vtmkhoi/DigitalMicroFluidics/docs/jebrail2012.pdf

# Lab on a Chip

## Miniaturisation for chemistry, physics, biology, materials science and bioengineering

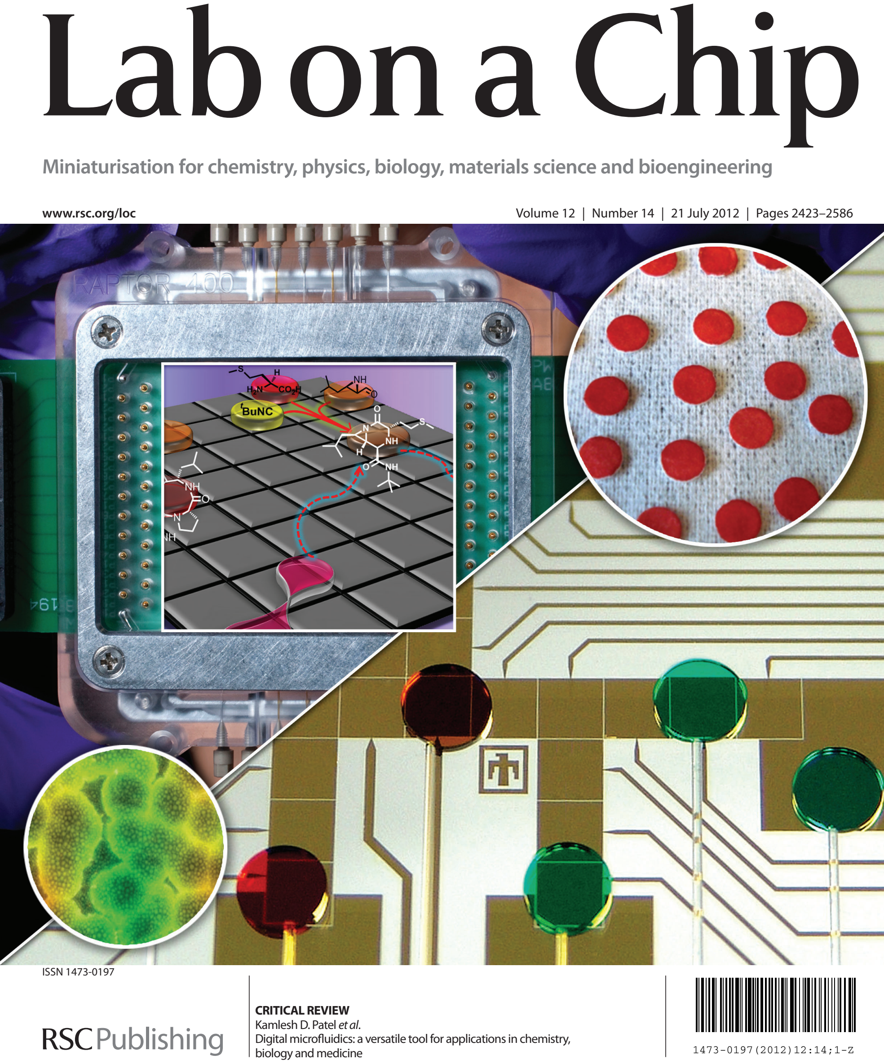
[picture p66: page 1]

1473-0197(2012)12:14;1-Z

ISSN 1473-0197

www.rsc.org/loc | Volume 12 | Number 14 | 21 July 2012 | Pages 2423–2586

CRITICAL REVIEW
Kamlesh D. Patel et al.
Digital microfl uidics: a versatile tool for applications in chemistry, biology and medicine
Downloaded by North Carolina State University on 24 January 2013 Published on 10 May 2012 on http://pubs.rsc.org | doi:10.1039/C2LC40318H View Article Online / Journal Homepage / Table of Contents for this issue

# Digital microfluidics: a versatile tool for applications in chemistry, biology and medicine

Mais J. Jebrail,a Michael S. Bartschb and Kamlesh D. Patel*b

Received 3rd April 2012, Accepted 4th May 2012
DOI: 10.1039/c2lc40318h

Digital microfluidics (DMF) has recently emerged as a popular technology for a wide range of applications. In DMF, nanoliter to microliter droplets containing samples and reagents can be manipulated to carry out a range of discrete fluidic operations simply by applying a series of electrical potentials to an array of patterned electrodes coated with a hydrophobic insulator. DMF is distinct from microchannel-based fluidics as it allows for precise control over multiple reagent phases (liquids and solids) in heterogeneous systems with no need for complex networks of connections, microvalves, or pumps. In this review, we discuss the most recent developments in this technology with particular attention to the potential benefits and outstanding challenges for applications in chemistry, biology, and medicine.

Introduction

The most common format for microfluidics or lab-on-a-chip devices is based on enclosed microchannels in a monolithic substrate. While such systems have been successfully used for applications in chemistry,¹⁻⁵ biology⁶⁻⁹ and medicine,¹⁰⁻¹² in this review, we focus on a related but distinct technology called digital microfluidics (DMF). Like microchannel-based fluidics, DMF is being used to miniaturize a wide range of applications, with the advantages of reduced reagent and solvent consumption, faster reaction rates and the capacity for integration (i.e., the lab-on-a-chip concept). In DMF, discrete droplets of samples and reagents are manipulated (i.e., dispensed from reservoirs, split, merged and mixed) with high-fidelity¹³,14 on an open surface by applying a series of electrical potentials to an array of electrodes.¹⁵,16 Although microchannels can also be used to manipulate droplets,¹⁷,18 typically entrained in an immiscible fluid stream, DMF is a distinct paradigm that offers several unique assets to the lab-on-a-chip field.
One unique feature of DMF is the capacity to address each reagent individually with no need for complex networks of tubing or microvalves (Fig. 1a). A second advantage is the ability to control liquids relative to solids with no risk of clogging – thus, as shown in Fig. 1b, DMF is a good match for the accommodation and analysis of solid samples.¹⁹⁻²² A third asset of DMF is its compatibility with a large range of volumes (see Fig. 1c), making it useful for preparative-scale sample handling.

a
Department of Biotechnology and Bioengineering, Sandia National Laboratories, 7011 East Avenue, MS 9292, Livermore, CA 94550
b
Advance System Engineering and Deployment, Sandia National Laboratories, 7011 East Avenue, MS 9292, Livermore, CA 94550 E-mail: kdpatel@sandia.gov; Fax: +1 925 294 3020; Tel: +1 925 294 3737

Mais J. Jebrail is an NSERC
Postdoctoral | Fellow | in | the
Department of Biotechnology & Bioengineering at Sandia National Laboratories in Livermore, California. Dr Jebrail received his BSc and MSc in Chemistry from York University and his PhD in Interdisciplinary Chemistry from University of Toronto. His primary research focuses on developing microfluidics-based systems for identifying pathogens triggered by bioweapons and infectious diseases.

Michael S. Bartsch is a Senior Member of the Technical Staff at Sandia National Laboratories in Livermore, California. He received a B.M.E. degree from the University of Dayton and MS and PhD degrees in mechanical engineering from Stanford University. His current research focuses on scalable microfluidic systems for micro- and nanoparticle synthesis, digital microfluidics for small scale laboratory automation, and novel bioassay implementations for rapid DNA forensic analysis and biosur-

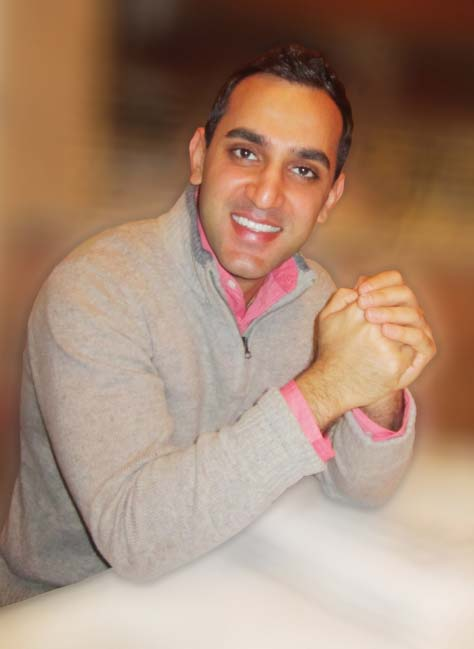
[picture p67: figure]
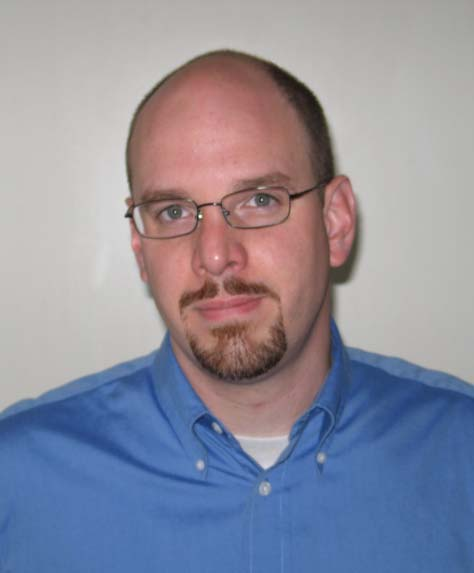
[picture p68: figure]

veillance applications. Mais J. Jebrail

Michael S. Bartsch

Lab on a Chip (http://dx.doi.org/10.1039/c2lc40318h) | Dynamic Article Links (http://dx.doi.org/10.1039/c2lc40318h)

### Cite this: Lab Chip, 2012, 12, 2452–2463

www.rsc.org/loc | CRITICAL REVIEW
2452 | Lab Chip, 2012, 12, 2452–2463 | This journal is -
The Royal Society of Chemistry 2012
Downloaded by North Carolina State University on 24 January 2013 Published on 10 May 2012 on http://pubs.rsc.org | doi:10.1039/C2LC40318H View Article Online

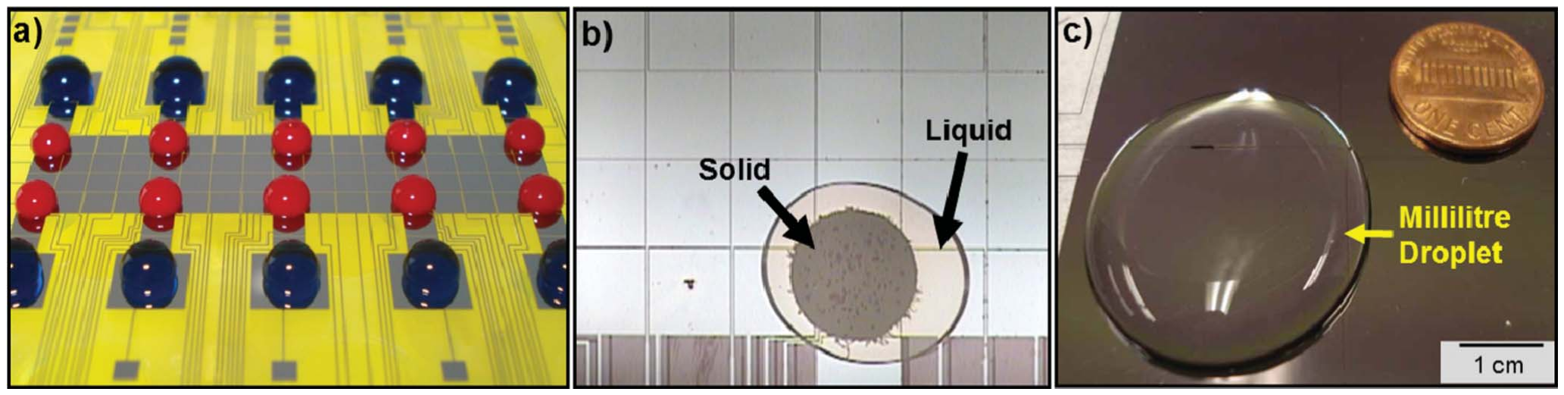
[picture p69: figure]

In this review, we will explore the key capabilities and challenges for DMF, some of which are summarized in Table 1.
The last digital microfluidic review was published in Lab on a Chip in 2009 by Malic et al.²³ Since that time, DMF has matured significantly with publications not reflected in the last review and a number of novel applications now being reported. In the following sections, we describe the physics and formats of digital microfluidics, followed by a discussion of the state-of-the-art for a variety of applications in chemistry, biology, medicine, and beyond.

Physics and formats of digital microfluidics

Digital microfluidics was popularized in the early 2000s by the Fair²⁴ and Kim²⁵ groups at Duke and UCLA, respectively. In these pioneering works, water droplets were made to move across an array of insulated electrodes upon application of electrical potentials. The technique was explained as being driven by surface tension, and was called ‘‘electrowetting’’ or ‘‘electrowetting-on-dielectric’’ (EWOD). This naming convention arose from the observation that the contact angle between an aqueous droplet and the device surface is dramatically reduced (i.e., wetted) during droplet movement. In the electrowetting paradigm, the two phenomena (droplet wetting and movement) were viewed as being cause-and-effect: droplet movement was understood as being a consequence of a force imbalance arising from non-symmetrical contact angles. However, this understanding does not explain droplet motion for liquids with a low surface tension that are movable yet exhibit no apparent changes in contact angle;²⁸ nor can it explain related phenomena such as contact angle saturation (i.e., the observed limit on contact angle change above a threshold in applied potential).
A more complete understanding of the physics of droplet actuation can be derived from electromechanical analysis,²⁹⁻³² which explains both wetting and droplet movement phenomena in terms of the electrical forces generated on free charges in the droplet meniscus (for conductive liquids) or on dipoles inside the droplet (for dielectric liquids). For the purposes of modeling, these forces can be estimated by integrating the Maxwell–Stress tensor, Tij (eqn (1)) (which can be derived from the Lorenz equation³³), over any arbitrary surface around the droplet:³⁰,34

Tij ~ e EiEj{1
2

dijE²

| (1)

where e is the dielectric constant of the medium surrounding the droplet, i and j refer to pairs of x, y, and z axes, dij is the Kronecker delta and E is the applied electric field. Unlike electrowetting, the electromechanical formulation explains the motion of dielectric liquids and liquids that do not experience a change in contact angle. In addition, it provides a rationale for the phenomenon of contact-angle saturation as an equilibrium between electrical and surface-tension forces.³⁰,31
As shown in Fig. 2a, digital microfluidic technology is typically implemented in one of two different configurations: the two-plate or closed format in which droplets are sandwiched between an actuation electrode substrate and a ground plane substrate, and the one-plate or open format in which droplets are placed on top of a single substrate patterned with both actuation and ground electrodes. In both configurations, an insulating layer is deposited on top of the actuation electrodes, and is typically covered by an additional hydrophobic coating to prevent the droplet sticking to the surface.
The two-plate and one-plate digital microfluidic configurations have complementary advantages. Two-plate DMF devices are compatible with the full range of fluidic operations: droplet

Fig. 1 Unique features of digital microfluidics a) DMF platform controlling twenty reagent droplets with no need for external hardware (i.e., connectors, valves, and pumps). Reproduced with permission from ref. 26. Copyright E 2011 Futurity.org. b) Picture of extraction liquid processing a solid dried blood spot by DMF. Reproduced with permission from ref. 21. Copyright E 2011 The Royal Society of Chemistry. c) Picture of a DMF platform used to manipulate a y 3 mL sample droplet. Reproduced with permission from ref. 27. Copyright E 2008 The Royal Society of Chemistry.

Kamlesh D. Patel is a research scientist and manager for the
Advance | Systems | Engineering
and | Development | Group | at
Sandia National Laboratories in Livermore, California. Dr Patel received his BS in Chemistry from Truman State University and PhD in Analytical Chemistry from UNC-Chapel Hill. With a background in separation science and years of experience in microsystems engineering, Dr Patel has applied microfluidic-based technology to new frontiers. Most recently, Dr Patel has turned his

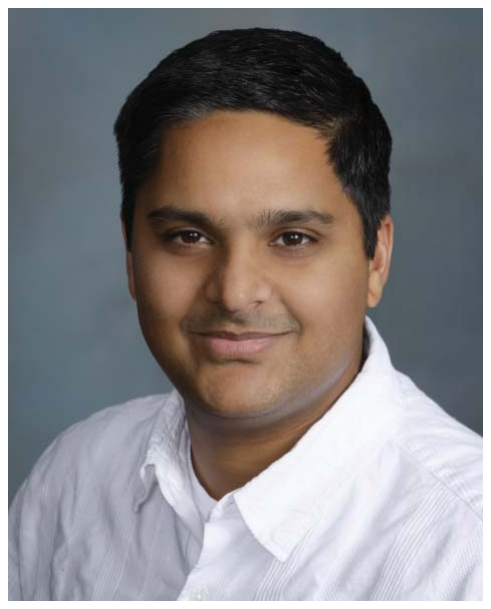
[picture p70: figure]

focus towards automating sample preparation techniques for nextgeneration sequencing, where he hopes to help in developing a strategy to characterize unknown pathogens related to disease outbreak.

Kamlesh D. Patel

This journal is -

The Royal Society of Chemistry 2012 | Lab Chip, 2012, 12, 2452–2463 | 2453
Downloaded by North Carolina State University on 24 January 2013 Published on 10 May 2012 on http://pubs.rsc.org | doi:10.1039/C2LC40318H View Article Online

Table 1 Capabilities of and challenges for digital microfluidics

Capabilities | Challenges
Easy to manipulate reagent droplets with no need for pumps, tubing and microvalves | Not suitable for chemical separations or continuous-flow synthesis
Can handle wide range of volumes (nL–mL), suitable for preparative applications | Incompatible with high temperatures and pressures
Compatible with aqueous and organic solvents | Difficulty moving concentrated biological samples without additives or oil matrix
Straightforward control over different phases | Incompatible with centrifugation
| Dielectric breakdown with high voltage usage

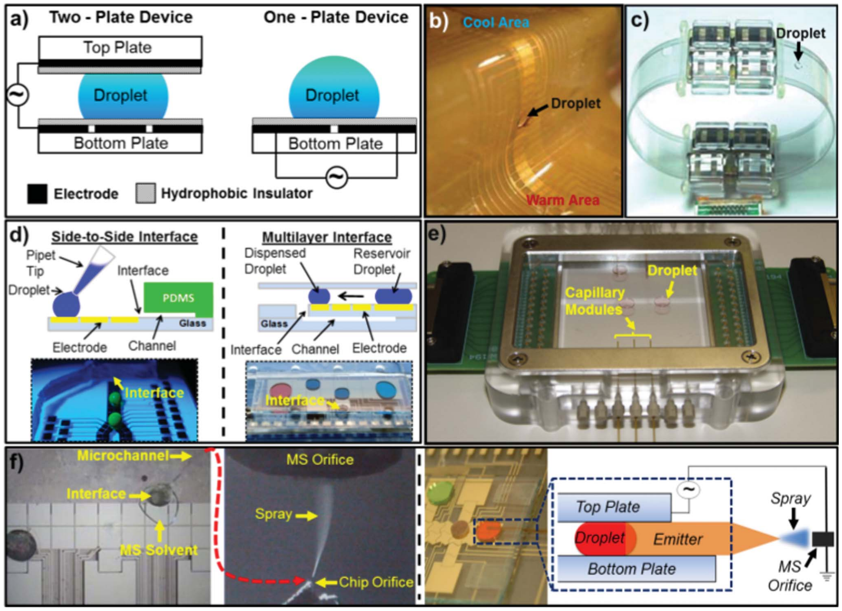
[picture p71: figure]

Fig. 2 Digital microfluidic formats. a) Side-view schematics of two- (left) and one-plate (right) DMF formats. Reproduced with permission from ref.
43. Copyright E 2010 Elsevier B.V. b) Picture of a flexible ‘‘All-Terrain Droplet Actuation’’ device moving a droplet from a warm to a cool area. Reproduced with permission from ref. 27. Copyright E 2008 The Royal Society of Chemistry. c) Picture of a wearable ‘‘droplet-on-a-wristband’’ device. Reproduced with permission from ref. 40. Copyright E 2011 The Royal Society of Chemistry. d) Schematics (top) and pictures (bottom) of two formats of ‘‘hybrid microfluidics,’’ which integrates DMF for sample processing with microchannels for separations. The side-to-side configuration (left) comprises a one-plate DMF device mated to a PDMS microchannel on a common substrate and the multilayer design (right) comprises a DMF array patterned on a top substrate mated to a network of microchannels in a glass substrate below. Reproduced with permission from ref. 42. Copyright E 2010 The American Chemical Society, and ref. 41. Copyright E 2008 The Royal Society of Chemistry. e) Image of a DMF device routing droplets toand-away-from capillary modules that are fixed between lower and upper substrates of DMF device. The electrodes on this device are not visible because they are formed from transparent Indium-Tin Oxide (ITO). Reproduced with permission from ref. 44. Copyright E 2011 Society for Laboratory Automation and Screening. f) Pictures (left) of mass spectrometry (MS) solvent introduced into spray microchannel (via interface hole) and sprayed offtip, and top and side views (right) of a capillary emitter sandwitched between the top and bottom plates of an assembled DMF device. Reproduced with permission from ref. 21. Copyright E 2011 The Royal Society of Chemistry, and ref. 45. Copyright E 2012 The American Chemical Society.
Downloaded by North Carolina State University on 24 January 2013 Published on 10 May 2012 on http://pubs.rsc.org | doi:10.1039/C2LC40318H View Article Online

dispensing, moving, splitting, and merging are all feasible.³⁵ In contrast, one-plate DMF devices are typically not capable of splitting or dispensing functionalities, but facilitate rapid sample and reagent mixing,³⁶ offer the capacity to manipulate large droplets²⁷ and provide better access to samples for external detectors or pipette-based liquid handling.²³
A second key distinction in format for digital microfluidic systems is the nature of the matrix surrounding droplets on the device. For many applications, this matrix is simply ambient air. This format is the most straightforward, but is susceptible to evaporation and may require humidified chambers to overcome this issue.³⁷ Another common format uses a matrix of oil,³⁸ which limits evaporation and reduces the surface energy, and thus requires lower electrical potentials for droplet actuation. Oil-immersed systems have drawbacks, however, including the requirement of gaskets or other structures to contain the oil, the potential for the unwanted liquid–liquid extraction of analytes into the surrounding oil,²⁷ incompatibility with oil-miscible liquids (e.g., organic solvents), and incompatibility with applications requiring drying droplets onto the device surface.³⁹
A third distinction for digital microfluidic device format is device geometry. DMF is typically implemented in planar formats (Fig. 1a), but the use of flexible platforms is growing in popularity. For example, Abdelgawad et al.²⁷ described the format of ‘‘All Terrain Droplet Actuation’’ (ATDA) using devices fabricated on flexible substrates, which were capable of droplet actuation on inclined, declined, and inverted surfaces. This format allows for straightforward integration of multiple physicochemical environments on the same device for applications requiring temperature cycling (Fig. 2b). Similarly, Fan et al.⁴⁰ developed a wearable ‘‘droplet-on-a-wristband’’ device formed from flexible substrates that can fit around patients’ wrists for the potential application of point-of-care testing (Fig. 2c).
A very recent trend for digital microfluidic device format is integration with microchannel-based elements such as separation columns. For example, ‘‘hybrid microfluidics’’⁴¹,42 combines the strength of DMF for sample processing with the speed and sensitivity of microchannel-based separations. Two formats for hybrid microfluidics have been reported. A side-by-side configuration⁴¹ comprises a one-plate DMF device mated to a PDMS microchannel (Fig. 2d, left). Devices formed in this manner were demonstrated to be useful for applications such as in-line sample labelling with fluorogenic reagents followed by separations. A multilayer configuration⁴² comprises a two-plate DMF device on top layers mated to a network of channels on a bottom layer (Fig. 2d, right). This format facilitates the implementation of complex processing regimens (e.g., multi-enzyme digestion of a proteomic sample) followed by electrophoretic separations. A strategy similar to hybrid microfluidics was reported by Gorbatsova et al.,

46 who mated samples controlled by DMF to the inlet of an external capillary for separations. In other work, our group⁴⁴,47 recently developed a novel in-plane capillarydigital microfluidic interface for robustly interconverting liquid samples between continuous-flow and discretized droplet formats (Fig. 2e). The architecture uses the DMF primarily as a central hub for scheduling, routing, and coordinating the transport of multiple reagents between external sample processing modules – in this particular case to prepare nucleic acid samples for next generation sequencing. This strategy has the unique benefit of enabling seamless sample manipulation at the microliter scale while maintaining the flexibility of modular integration.
Methods have also been developed to couple digital microfluidics to nanoelectrospray ionization emitters for direct analysis by mass spectrometry. Jebrail and Yang et al.²¹ initially reported a method relying on multilayer hybrid microfluidics⁴² for in-line analysis, in which samples were transferred from a DMF module (on the top of the device) to a microchannel (on the bottom of the device) with an integrated nanoelectrospray ionization (nESI) emitter for mass spectrometry (Fig. 2f, left). One drawback of this method is the complexity of device fabrication and alignment and the need to thermally bond the two substrates together to form the device. Recently, Shih and Yang et al. reported a new DMF–nESI interface that requires significantly simpler fabrication.⁴⁵ The interface is assembled by inserting a conventional pulled-glass capillary nESI emitter between the top and bottom substrates of an assembled digital microfluidic device (Fig. 2f, right). This interface is similar to work reported simultaneously by Baker and Roper,⁴⁸ but with the key difference being that the nESI interface requires external hardware (i.e., pressure source and N2 gas) for sampling into the mass spectrometer. These approaches show significant potential for future lab-on-a-chip systems.

Digital microfluidic applications in chemistry

The format of digital microfluidics, in which droplets can be used as individually addressable microreactors, seems well suited for chemical synthesis. This idea was reinforced when Chatterjee et al.²⁸ demonstrated the capacity of DMF to actuate organic solvents including acetone, acetonitrile, ethanol, dichloromethane and others. In an early demonstration of chemical applications in DMF format, Millman et al.⁴⁹ synthesized a wide variety of micro-particles, including capsules, semiconducting microbeads, and inhomogeneous striped and ‘‘eyeball’’ particles (Fig. 3a). Droplets containing suspensions of micro/nano particles, polymer solutions, and polymer precursors were merged and mixed to yield the different types of particles. In another example of synthesis applications on digital microfluidc devices, Dubois et al.⁵⁰ implemented Grieco’s reaction using ionic liquid droplets as microreactors to synthesize tetrahydroquinolines. In this reaction, an onium salt is reacted with benzaldehyde derivatives and excess indene in an ionic liquid matrix to obtain tetrahydroquinolines. Ionic liquids are advantageous for this application because of their low vapor pressure – reactions can be implemented in small droplets (, 1 mL) on single-plate devices with no evaporation. In addition, ionic liquids have other advantages for use with DMF, such as intrinsic conductivity and thermal stability.
While the studies described above established the compatibility of digital microfluidics with chemical synthesis, they used simple one-plate devices that were capable of carrying out only a single, serial reaction with no dispensing, splitting, active mixing, or flexibility in droplet volumes. The Wheeler group introduced the first two-plate DMF platform for chemical synthesis that is suitable for the control of multi-step reactions in parallel.⁵¹ This platform was used to carry out the synchronized synthesis of five peptide macrocycles from three different components (amino
The Royal Society of Chemistry 2012 | Lab Chip, 2012, 12, 2452–2463 | 2455
Downloaded by North Carolina State University on 24 January 2013 Published on 10 May 2012 on http://pubs.rsc.org | doi:10.1039/C2LC40318H View Article Online

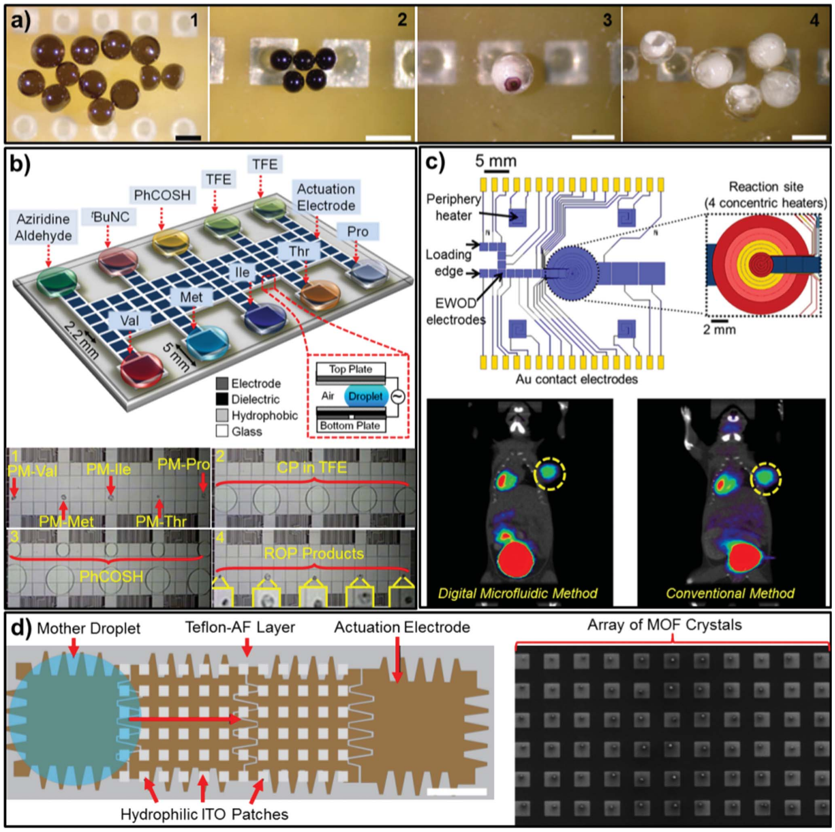
[picture p72: figure]

Fig. 3 Digital microfluidic applications in chemistry. a) Pictures depicting micro-particles synthesized using DMF. The products include conductive gold/SU-8 particles (1), semiconducting polypyrrole particles (2), ‘‘eyeball’’ microbeads (3), and cup-shaped particles formed by drying water droplets that were originally encapsulated in latex (4). Scale bars are 1 mm; reprinted with permission from ref. 49. Copyright E 2005 Nature Publishing Group.
b) Schematic (top) of a DMF device used for synchronized synthesis, and sequence of frames from a movie (bottom) illustrating the steps in DMF synthesis of aziridine ring-opened peptide (ROP) products. Peptide macrocycles (PM) are solubilized in trifluoroethanol (TFE) (frames 1,2), then merged (frames 3,4) with droplets containing thiobenzoic acid (PhCOSH), followed by isolation of the ROP products. The insets in frame 4 are magnified images of the dried products. Reproduced with permission from ref. 51. Copyright E 2010 John Wiley & Sons, Inc. c) Schematic (top) of a DMF device with four concentric heaters for synthesis of radiotracer [¹⁸F]FDG, and positron emission tomography images of a mouse bearing a lymphoma xenograft tumor in the right shoulder (dashed circle) after administration of [¹⁸F]FDG prepared by DMF (left) and conventional method (right). Reproduced with permission from ref. 52. Copyright E 2012 National Academy of Sciences. d) Top-view schematic (left) of a mother droplet moving across an array of indium-tin oxide (ITO) micropatches formed in a Teflon-AF background matrix and a scanning electron microscope image of single metal–organic framework (MOF) crystal arrays (right) synthesized by DMF. Reproduced with permission from ref. 53. Copyright E 2012 John Wiley & Sons, Inc.
Downloaded by North Carolina State University on 24 January 2013 Published on 10 May 2012 on http://pubs.rsc.org | doi:10.1039/C2LC40318H View Article Online

acids, aziridine aldehyde and tert-butyl isocyanide) followed by late-stage modification with thiobenzoic acid to generate aziridine ring-opened products. As shown in Fig. 3b, the DMF device featured ten reagent reservoirs and eighty-eight actuation electrodes dedicated to dispensing, merging, and mixing droplets of reagents and products. In other work, Keng et al.⁵² developed an integrated two-plate DMF device with four concentric heaters for synthesizing 2-[¹⁸F]fluoro-2-deoxy-D-glucose ([¹⁸F]FDG), a widely used radiotracer for imaging living subjects with positron emission tomography, with high and reliable radio-fluorination efficiency (. 85%) (Fig. 3c, top). DMF synthesized [¹⁸F]FDG was biodistributed (in vivo) in mice bearing lymphoma xenograft tumors and exhibited comparable uptake in tumors to [¹⁸F]FDG prepared using conventional methods (Fig. 3c, bottom). Finally, Witters et al. used DMF to synthesize single metal–organic framework (MOF) crystals in a high-throughput fashion.⁵³ As shown in Fig. 3d, library HKUST-1 [Cu3(BTC)2] crystals were printed by transporting a mother droplet of HKUST-1 precursor solution over an array of indium-tin oxide micropatches (in a Teflon-AF background matrix) on the top plate of a DMF device. Among other benefits, the authors anticipate that this technology can pave the way for straightforward post-synthesis modification of printed MOF crystals with different functionalities.
In comparison with other microfluidic technologies (e.g., enclosed microchannels), digital microfluidics is particularly well suited to synthesis, as DMF allows for precise control over multiple reagent phases. For example, a critical step in the synthesis of aziridine ring-opened products (as described above) is the removal of the solvent and re-dissolution of the crystalline peptide macrocycles for further processing (Fig. 3b, frames 1–2). This highlights the flexibility of DMF – the solvent volumes used to re-dissolve a particular solid can be readily varied. This stands in contrast to microchannel-based systems, in which working volumes are defined by the channel dimensions and cannot be changed.
The most useful features of digital microfluidics for synthesis include the individual addressing of all reagents with no need for complex networks of microvalves,⁵⁴,55 chemically inert Teflonbased device surfaces that facilitate the use of organic solvents and easy access to reasonably large amounts of products for off-chip analysis. On the other hand, DMF is not appropriate for all synthetic applications; for example, reactions performed at high temperatures and pressures or those that require in-line purification are better suited for closed microchannel systems⁵⁶ and there are several unique advantages associated with modular continuous flow reactors formed in microchannels (also known as mesofluidics¹,57). Nevertheless, the potential benefits of DMF as a synthetic platform have yet to be fully explored, suggesting considerable room for innovation in the future.

Digital microfluidic applications in biology

Digital microfluidics is an attractive platform for biological applications,⁴³ which often require the use of expensive or precious reagents. A challenge for such applications is the nonspecific adsorption of biological molecules to device surfaces (biofouling), which can lead to sample loss or cross-contamination. In the context of DMF, biomolecules adsorbed to device surfaces can result in droplet sticking, which can render fouled devices useless. Strategies have been developed to overcome this problem. For example, DMF devices making use of an oil matrix reduce the opportunity for biomolecules to come into contact with surfaces, which limits the extent of fouling.⁵⁸ For applications that are not compatible with oil, an alternative strategy is to mix samples and reagents with low concentrations of additives such as PluronicE⁵⁹,60 or graphene oxide⁶¹, which facilitates the actuation of serum and other concentrated biochemical reagents while reducing fouling. Lastly, one can use a removable hydrophobic insulator, such that each successive experiment is implemented on a fresh device surface.⁶² These adaptations have made DMF compatible with a wide range of applications in biology, as described below.
Handling and characterizing samples of DNA have become critical steps for a wide range of applications, especially molecular biology. Accordingly, a number of examples of digital microfluidic DNA manipulation have been published. Early studies included using DMF to study the repair of oxidized lesions in oligonucleotides by Jary et al.⁶³ In this work, droplets containing a DNA repair enzyme and damaged DNA were merged by DMF, incubated, and then the repaired DNA was detected by fluorescence microscopy. Liu et al.⁶⁴ demonstrated a similar application, in which a DMF device was developed to facilitate DNA ligation by merging droplets containing vector DNA and the enzyme, DNA ligase. In other studies, Malic et al.⁶⁵,66 carried out the on-chip immobilization of thiolated DNA probes followed by hybridization with droplets containing complementary oligonucelotide target sequences. Measurements were carried out by surface plasmon resonance imaging and revealed a two-fold increase in the efficiency of DNA immobilization under an applied potential in comparison to passive immobilization.
The most complete DNA application using DMF was initially reported by Chang et al.,

67 who implemented the polymerase chain reaction (PCR). In this work, a DMF device with an embedded micro-heater was developed to facilitate thermal cycling. The fluorescent signals from DNA amplified on-chip were comparable to those generated using a bench-scale PCR machine with 50% and 70% reductions in total time and sample consumption, respectively. In other work, Sista et al.⁶⁸ performed a 40-cycle real-time PCR in 12 min by shuttling a droplet through different temperature zones. In addition, Pollack and coworkers from Advanced Liquid Logic (ALL; www.liquidlogic.com) improved on previous methods by developing a multifunctional DMF cartridge capable of performing real-time PCR, immunoassays and sample preparation assays.⁶⁹ The cartridge was operated using a custom-built benchtop instrument equipped with all of the required control and detection capabilities for performing multiplexed real-time PCR. More recently, the same group utilized their digital microfluidic-based instrument to sequence DNA using a pyrosequencing method (Fig. 4a).⁷⁰ For proof-of-concept, a portion of a 229 bp Candida parapsilosis template was sequenced and over 60 bp of sequence was generated with 100% accuracy. Lastly, our group developed a DMF distribution hub for integrating multiple subsystem modules for automated library template construction for next generation sequencing (NGS). This DMF hub platform not only executed the sample preparation protocol,⁴⁴ but also integrated a

The Royal Society of Chemistry 2012 | Lab Chip, 2012, 12, 2452–2463 | 2457
Downloaded by North Carolina State University on 24 January 2013 Published on 10 May 2012 on http://pubs.rsc.org | doi:10.1039/C2LC40318H View Article Online

quantitative capillary electrophoresis module for the size-based quality control of the library prior to sequencing.⁴⁷
Digital microfluidics has also been applied to conduct enzyme assays. In one of the first reports, Taniguchi et al.⁷¹ demonstrated a bioluminescence assay for ATP using the luciferase enzyme. Later, Nichols and Gardeniers⁷² carried out timesensitive measurements by using DMF to mix the reagents and MALDI time-of-flight mass spectrometry to investigate the presteady-state kinetics of the enzyme, tyrosine phosphatase. Subsequently, Miller⁷³ et al. applied DMF to the study of enzyme kinetics by mixing and merging droplets of alkaline phosphatase with fluorescein diphosphate on a multiplexed DMF device. Enzyme reaction coefficients, Km and kcat, generated by DMF agreed with literature values, and the assays used much smaller volumes and had higher sensitivity than conventional methods. Recently, Fiddes and Luk et al.²² also demonstrated the action of alkaline phosphatase on fluorescein diphosphate using cylindrical hydrogel discs incorporated in DMF devices (Fig. 4b). In this work, agarose gel discs were modified with alkaline phosphatase enzyme molecules, and droplets containing fluorescein diphosphate were dispensed and merged onto the gels for the cleavage of phosphate groups and the generation of fluorescein.
The capacity to address many reagents and phases simultaneously makes digital microfluidics a good fit for applications in proteomics as well. Early work in this area focused on the combination of DMF sample handling with detection by matrix assisted laser desorption ionization mass spectrometry (MALDI-MS).³⁹,74,75 More recently, Jebrail et al. implemented a DMF-based protocol for extracting and purifying proteins from complex biological mixtures (e.g., serum and cell lysate) by precipitation, rinsing, and resolubilization.¹⁹ The method has protein recovery efficiencies comparable to conventional techniques (¢ 80%) and has the benefit of not requiring centrifugation. Processes relying on centrifugation are challenging to implement in most systems based on lab-on-a-chip devices, including DMF, and are therefore avoided whenever possible. In other work, Luk et al.⁷⁶ and Chatterjee et al.⁷⁷ applied DMF to key proteomic processing steps that commonly follow protein extraction, including reduction, alkylation, and digestion. Nelson et al.⁷⁸ improved upon these techniques by integrating resistive heating and temperature sensing elements for straightforward integration with MALDI-MS (Fig. 4c). Jebrail et al.⁷⁹ integrated many of these methods into an automated digital platform including protein precipitation, rinsing, resolubilization, reduction, alkylation, and digestion. Finally, Luk and Fiddes et al.⁸⁰ integrated agarose discs (y2 mm diameter) bearing immobilized enzymes (e.g., trypsin or pepsin) into DMF systems for digesting proteins. Digital microfluidics has also proven to be a useful platform for carrying out immunoassays. Sista et al.⁸¹ reported a dropletbased magnetic bead immunoassay using DMF to detect insulin and interleukin-6. In this work, a droplet of analyte and a second droplet containing magnetic beads (modified with capture antibodies), blocking proteins, and reporter antibodies were merged to form capture antibody–antigen–reporter antibody complexes. A magnet was then used to immobilize the beads such that the supernatant could be driven away. The assay had low detection limits: less than 10 pmol L²¹ and 5 pg mL²¹ for insulin and interleukin-6, respectively. In a separate study, Sista

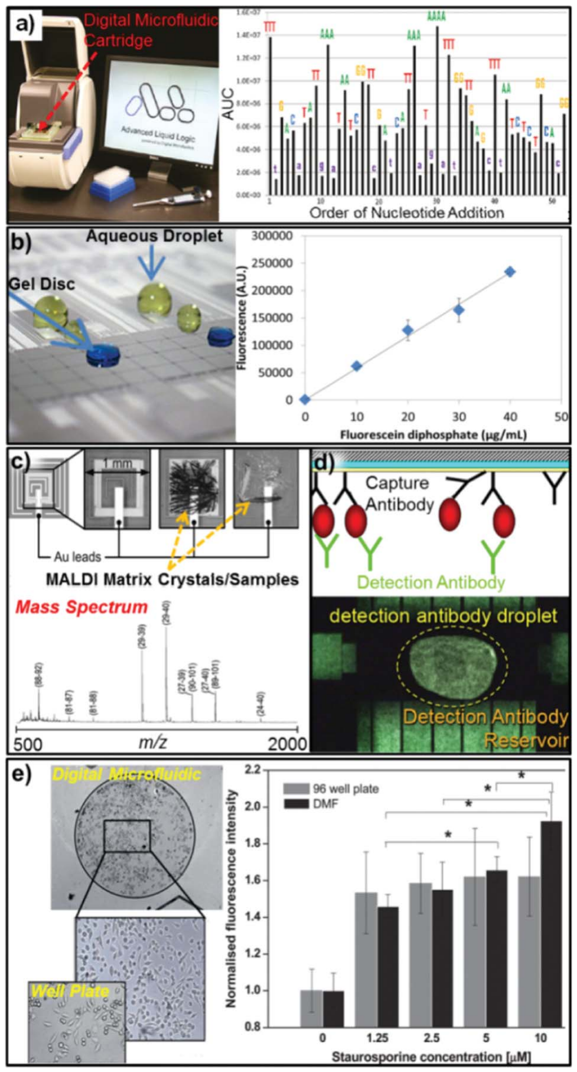
[picture p73: figure]

Fig. 4 Digital microfluidic applications in biology. a) Picture (left) of a sequencing instrument from Advanced Liquid Logic, and a pyrogram (right) of the Candida parapsilosis template. Reproduced with permission from ref. 70. Copyright E 2011 The American Chemical Society. b) Image (left) of gel discs on a DMF device with no top plate and the fluorescence response curve (right) as a function of fluorescein diphosphate concentration. Reproduced with permission from ref. 22. Copyright E 2012 American Institute of Physics. c) Pictures (top) of a MALDI matrix and sample crystals grown after the evaporation of the solvent by resistive heating and a MALDI-MS spectrum (bottom) of cytochrome c digested at 40 uC. Reproduced with permission from ref. 78. Copyright E 2010 The American Chemical Society. d) Schematic (top) depicting an IgG sandwich immunoassay, and picture (bottom) of a droplet containing detection antibody (FITC-labeled anti-IgG). Reproduced with permission from ref. 82. Copyright E 2011 Springer. e) Pictures (left) of HeLa cells on a hydrophilic site on a DMF device and (inset) cells grown on a well-plate, and the dose-response curve (right) of caspase-3 activity as a function of staurosporine concentration from cells assayed on a 96 well plate and DMF device. Reproduced with permission from ref. 83. Copyright E 2012 The Royal Society of Chemistry.

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

et al. implemented a similar method for detecting cardiac troponin I in whole blood.⁶⁸ Recently, Miller et al.⁸² developed a DMF platform for similar immunoassay applications implemented without beads or magnets. As shown in Fig. 3d, the method relied on device surfaces modified with spots of capture antibody (Fc-specific anti-human IgG), which binds antigen to the droplet sample and is in turn recognized by detection antibodies.
Cell-based assays have also been a popular target for digital microfluidics, as the reagents and other materials are often prohibitively expensive for large-volume techniques. In their initial work, Barbulovic-Nad et al. implemented a toxicity assay in which droplets carrying Jurkat-T cells were merged with droplets containing different concentrations of the surfactant Tween 20 (lethal to cells) and were then merged again with droplets carrying viability dyes to generate dose-response curves.⁸⁴ The DMF assay was more sensitive than conventional methods and had no significant effects on cell vitality. This agrees with a study conducted by Zhou et al., in which no increase in the number of dead osteoblasts was observed after droplet actuation.⁸⁵ Fan et al.⁸⁶ used dielectrophoresis to separate neuroblastoma cells to different regions of droplets that were manipulated by DMF. The original droplets were then split into daughter droplets containing different cell densities. Shah et al.⁸⁷ improved upon these techniques by integrating DMF with optoelectronic tweezers for precise cell handling. The Wheeler group developed a DMF-driven method of solution replacement for complete cell culture (i.e., cell seeding, growth, detachment, and re-seeding on a fresh surface, etc.) and analysis, which they have termed ‘‘passive dispensing.’’ 37,88,89 In this approach, an aqueous droplet is driven across a hydrophilic site formed on the surface of the bottom³⁷ or top plate⁸⁸,89 of a DMF device, which results in the spontaneous formation of a sub-droplet dubbed a ‘‘virtual microwell’’. Utilizing the above mechanism, Bogojevic et al.⁸³ recently developed the first DMF device implementing a multiplexed cell-based apoptosis assay. In this work, HeLa cells were seeded and grown on hydrophilic sites patterned on the top plate of DMF device, and a 6-plex caspase-3 activity assay was conducted using staurosporine as a model agonist (Fig. 4e). The method generated dose-response profiles of caspase-3 activity as a function of staurosporine concentration comparable to conventional techniques (i.e., pipetting, aspiration, and 96-well plates.), but it yielded lower detection limits, greater dynamic range, and a 33-fold reduction in reagent consumption. Note that the above cell based assays required low PluronicE concentrations (0.02–0.2% w/v) to facilitate cell droplet movement.

Digital microfluidic applications in medicine

The precise control over different reagents, phases (i.e., liquids relative to solids¹⁹,20,51,80,90 and immiscible solvents²⁰,91) and volumes afforded by digital microfluidics makes it well suited to applications in medicine. In an important first step toward clinical applications, the Fair group³⁸ developed a series of glucose assays in physiological fluids (serum, saliva, plasma, and urine) with actuation by DMF (see Fig. 4a). More recently, Sista et al.⁶⁸ developed a DMF technique to extract DNA from whole blood samples using magnetic beads with integrated analyses by immunoassays and PCR.
Noha and Jebrail et al. developed a digital microfluidic method for processing 1 mg samples of breast tissue homogenate and 1 mL samples of blood and serum for the quantitation of steroid hormones.²⁰ In a typical assay, a sample was chemically lysed, the estradiol extracted into a polar solvent, the unwanted constituents were extracted into a nonpolar solvent by liquid– liquid extraction and the extract was delivered to a collection reservoir for off-chip analysis (Fig. 4b). The DMF method uses a sample size that is 1000–4000 times smaller than conventional methods for the extraction and quantification of steroids and was 20–30 times faster.
Digital microfluidic techniques provide similar benefits for analyzing newborn dried blood spot (DBS, i.e., a sample of filter paper bearing dried blood) samples used to screen for metabolic disorders. Recently, a cover story in Chemical & Engineering News⁹³ described the increasing prevalence of DBS samples for disease detection and drug development, driven by advantages such as small sample consumption, easy shipment and storage and reduced use of animal testing. However, DBS samples present several challenges, including manual processing (e.g., solvent extraction) and lengthy analysis times⁹³, drawbacks that can potentially be alleviated when using DMF.
The Wheeler group²¹ reported the first microfluidic method for in-line extraction and analysis of analytes in DBS samples by mass spectrometry. In this work, biomarkers for amino acid metabolism disorders (e.g., methionine, phenylalanine and tyrosine) were extracted from the DBS of newborn patients and derivatized using digital microfluidics, then quantified by tandem mass spectrometry (Fig. 5c). The prototype microfluidic system was able to correctly identify newborn patients suffering from metabolic disorders (e.g., phenylketonuria) while significantly reducing the required sample volume (20 mL vs. 170– 450 mL) and analysis time (y1h vs. . 3.5 h) relative to conventional methods. In a separate study, the same group improved on their previous method by including a new, straightforward interface between DMF and mass spectrometry for in-line analysis.⁴⁵ This method was used to perform on-chip extraction and quantification of succinylacetone, a specific marker of tyrosinemia type 1, in DBS samples. Finally, Advanced Liquid Logic validated a disposable DMF cartridge for rapid, multiplexed analysis of newborn DBS extracts for lysosomal storage diseases (Fig. 5d).⁹² Eleven DBS extracts were simultaneously processed on a single cartridge and analyzed for Pompe and Fabry disorders (caused by acid a-glucosidase and a-galactosidase deficiencies) using fluorometric enzyme assays. These new DMF methods have the potential to contribute to a new generation of analytical techniques for quantifying analytes in DBS samples in a wide range of applications.

Cross-cutting applications

The unique characteristics of digital microfluidics have also made this technology attractive for a diverse set of applications that do not fit neatly into a single category as described above. For example, Zhao et al.⁹⁴ manipulated air bubbles instead of droplets on DMF devices and used these bubbles to effect a chemical reaction between gaseous reagents. In other work,

The Royal Society of Chemistry 2012 | Lab Chip, 2012, 12, 2452–2463 | 2459
Downloaded by North Carolina State University on 24 January 2013 Published on 10 May 2012 on http://pubs.rsc.org | doi:10.1039/C2LC40318H View Article Online

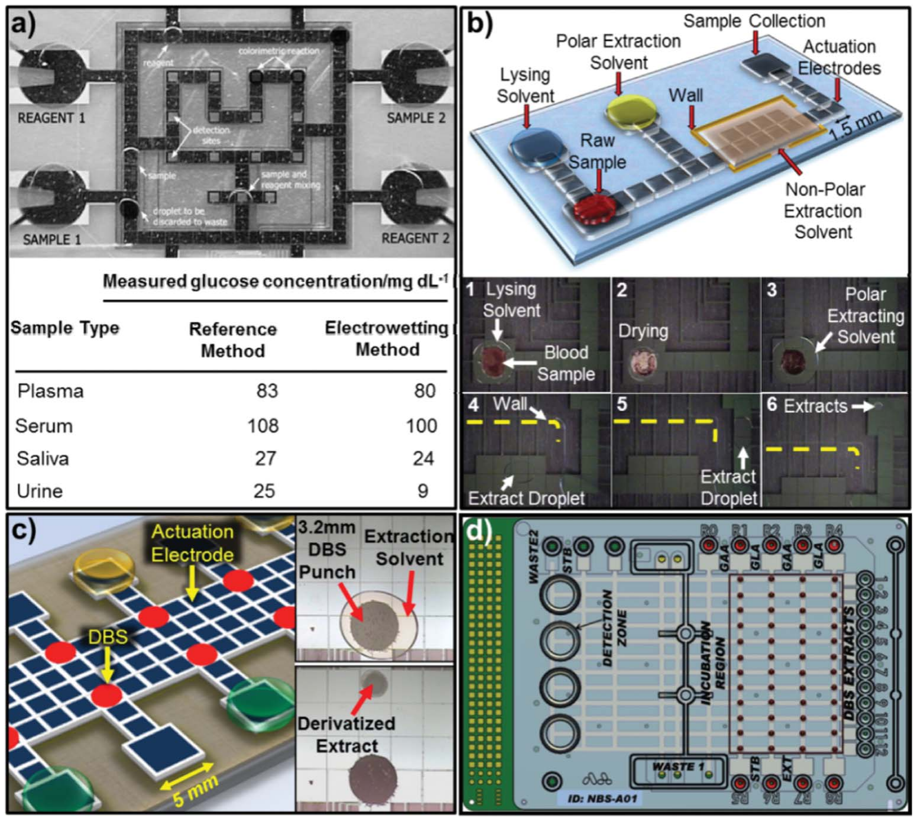
[picture p74: figure]

droplets controlled by DMF were used to collect particles from the surfaces of perforated microfilter membranes, which may be useful for sampling bioaerosols in environmental monitoring applications.⁹⁵ Gao et al. used DMF for rapid colorimetric detection of mercury(II) by mixing a detector droplet composed of a conjugated polymer and a label-free mercury-specific oligonucleotide probe with a mercury ioncontaining droplet.⁹⁶ Recently, Kuehne et al.⁹⁷ reported the miniaturization of dye-lasers by using DMF. As shown in Fig. 6b, the emission wavelength of the DMF dye laser can be altered by moving droplets of different dye solutions in and out of an excitation beam. This technique has the potential to be beneficial for a wide range of applications requiring on-chip optical sensing.
In another example, Polous et al.⁹⁸ developed an integrated DMF device bearing thin-film electrodes for the formation and analysis of lipid bilayer membranes (Fig. 6c). In this work, aqueous droplets surrounded by a lipid-containing organic oil were moved close to each other and lipid bilayer formation at the interface was probed using electrochemical techniques. Son et al.⁹⁹ used DMF to transport and process relatively large living organisms, as shown in Fig. 6d. For example, the dechorionation (i.e., removing the chorion of an embryo to facilitate microinjection and accelerate growth) of a zebrafish embryo was carried out by merging droplets containing digestive reagents and an embryo. This work represents an initial step towards using DMF as an alternative to microwell plates for applications involving multicellular organisms.
Au and Shih et al.¹⁰⁰ reported a microbioreactor powered by DMF for the automated culture and on-chip analysis of microorganisms (e.g., bacteria, algae and yeast). Lapierre et al.¹⁰¹ coupled DMF to a surface-assisted laser desorption– ionization (SALDI) silicon nanowire-based interface for mass spectrometry (MS) analysis. The integrated system allows for a rapid, straightforward and highly sensitive MS analysis of small biomolecules. Finally, Choi et al.¹⁰² equipped a DMF device with field effect transistors (FET) to electrically detect biomolecules. As shown in Fig. 6e, FET-based biosensors were embedded in the center of droplet-actuation electrodes for tracing an influenza antibody in real-time without labeling.

Fig. 5 Digital microfluidic applications in medicine. a) Picture of DMF (top) used to perform glucose assays, and table (bottom) comparing glucose concentrations in different samples obtained by DMF and a reference method. Reproduced with permission from ref. 38. Copyright E 2004 The Royal Society of Chemistry. b) Schematic (top) of a DMF device for extracting and purifying estrogen from tissue, blood, or serum, and a series of frames (bottom) from a movie (1 to 6) illustrating the key steps in the DMF-based extraction of estrogen from a 1 ml droplet of human blood. Reproduced with permission from ref. 20. Copyright E 2009 The American Association for the Advancement of Science. c) Schematic of dried blood spots (DBS) on a DMF device (left) and pictures (right) depicting sample processing of a single 3.2 mm DBS by DMF. Reproduced with permission from ref. 21. Copyright E 2011 The Royal Society of Chemistry. d) Schematic of disposable DMF cartridge developed by Advanced Liquid Logic Inc. for multiplexed enzyme analyses of DBS extracts. Reproduced with permission from ref. 92. Copyright E 2011 The American Association for Clinical Chemistry.

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

Summary and outlook for the future

Since its debut in the early 2000s as a basic method for moving water droplets on a surface, digital microfluidics (DMF) has matured from something of a curiosity into a technology that is making unique contributions to laboratory practice in chemistry, biology, medicine, and other fields. The most active application area for DMF so far has been biology, but we expect this to change in the future as the unique features of DMF become more widely recognized. For example, we believe that the potential benefits of DMF for chemical synthesis and multiphase sample manipulation have yet to be fully investigated and exploited. Moreover, we anticipate that DMF will increasingly find applications in portable and deployable applications like forensic science, biosurveillance, and environmental sampling. Several of the advantages and disadvantages of DMF described here are listed in Table 1. While challenges remain, DMF technology has matured rapidly in a fairly short time and shows great promise for growth beyond academic and research labs. At least one company, Advanced Liquid Logic (ALL), has been established to translate the capabilities of DMF to end users, and there are likely to be others. Moreover, ancillary players such as Luminex Corporation (www.luminexcorp.com) and NuGen Technologies (www.nugeninc.com) are partnering with ALL and others to develop small-footprint, cost-efficient systems that reduce labor costs and produce fast and accurate analytical results. In the next decade, we speculate that an everexpanding community of researchers spanning academia, industry, and government will continue to push DMF technology to address an ever-growing list of challenging problems in chemistry, biology, medicine, and beyond.

Acknowledgements

We sincerely thank Dr Aaron Wheeler and the members of the Wheeler Lab for being a key resource and engaging in helpful discussions during the preparation of this manuscript. MJJ thanks the Natural Sciences and Engineering Research Council (NSERC) of Canada and the Sandia Laboratory Directed Research and Development (LDRD) program for funding. Sandia is a multiprogram laboratory operated by the Sandia Corporation, a Lockheed Martin Company, for the United States Department of Energy’s National Nuclear Security Administration under contract DE-AC04-94Al85000.

References

1 I. R. Baxendale, S. V. Ley, A. C. Mansfield and C. D. Smith, Angew. Chem., Int. Ed., 2009, 48, 4017–4021.
2 S. Marre and K. F. Jensen, Chem. Soc. Rev., 2010, 39, 1183–1202. 3 B. F. Cottam, S. Krishnadasan, A. J. de Mello, J. C. de Mello and
M. S. P. Shaffer, Lab Chip, 2007, 7, 167–169.
4 Y. J. Wang, W. Y. Lin, K. Liu, R. J. Lin, M. Selke, H. C. Kolb,
N. G. Zhang, X. Z. Zhao, M. E. Phelps, C. K. F. Shen, K. F. Faull and H. R. Tseng, Lab Chip, 2009, 9, 2281–2285.
5 Y. Hennequin, N. Pannacci, C. P. De Torres, G. Tetradis-Meris,
S. Chapuliot, E. Bouchaud and P. Tabeling, Langmuir, 2009, 25, 7857–7861.
6 D. Chen, W. Du, Y. Liu, W. Liu, A. Kuznetsov, F. E. Mendez,
L. H. Philipson and R. F. Ismagilov, Proc. Natl. Acad. Sci. U. S. A., 2008, 105, 16843–16848.
7 A. B. Theberge, F. Courtois, Y. Schaerli, M. Fischlechner, C. Abell,
F. Hollfelder and W. T. S. Huck, Angew. Chem.-Int. Edit., 2010, 49, 5846–5868.

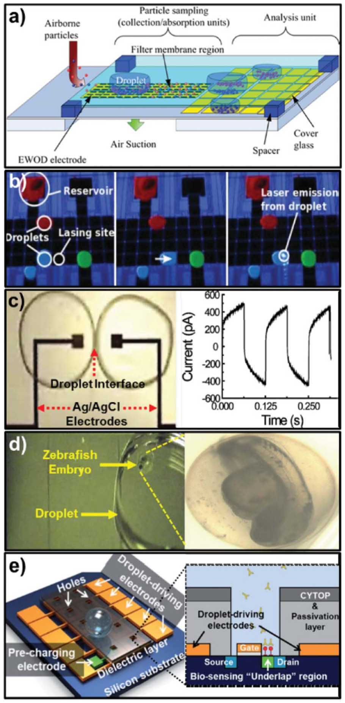
[picture p75: figure]

Fig. 6 Cross-cutting applications of digital microfluidics. a) A schematic of a DMF-powered monitoring system for airborne particle sampling and analysis. Reproduced with permission from ref. 95. Copyright E 2009 IOP Publishing. b) Images from left to right of a blue dye droplet actuated to the lasing site by DMF for emission. Reproduced with permission from ref. 97. Copyright E 2011 The Royal Society of Chemistry. c) Picture (left) of a DMF device integrated with Ag/AgCl electrodes controlling two aqueous droplets, each surrounded by a lipid-containing organic phase, and electrical measurement (right) of bilayer formation at the interface of the two droplets. Reproduced with permission from ref. 98. Copyright E 2009 American Institute of Physics.
d) Picture of a digital microfluidic device controlling a droplet containing a zebrafish embryo for processing (left) and picture (right) of a magnified embryo on the device. Reproduced with permission from ref. 99. Copyright E 2009 The Royal Society of Chemistry. e) Top-view schematic of a DMF device embedded with field effect transistors (FET) biosensors (left) and an exploded cross-sectional view of the biosensor (right). Reproduced with permission from ref. 102. Copyright E 2012 The Royal Society of Chemistry.
The Royal Society of Chemistry 2012 | Lab Chip, 2012, 12, 2452–2463 | 2461
Downloaded by North Carolina State University on 24 January 2013 Published on 10 May 2012 on http://pubs.rsc.org | doi:10.1039/C2LC40318H View Article Online

8 S. Ko¨ster, F. E. Angile`, H. Duan, J. J. Agresti, A. Wintner, C. Schmitz, A. C. Rowat, C. A. Merten, D. Pisignano, A. D. Griffiths and D. A. Weitz, Lab Chip, 2008, 8, 1110–1115.
9 R. W. Doebler, B. Erwin, A. Hickerson, B. Irvine, D. Woyski, A. Nadim and J. D. Sterling, JALA, 2009, 14, 119–125.
10 C. W. Yung, J. Fiering, A. J. Mueller and D. E. Ingber, Lab Chip, 2009, 9, 1171–1177.
11 D. Wlodkowic and J. M. Cooper, Curr. Opin. Chem. Biol., 2010, 14, 556–567.
12 R. Fan, O. Vermesh, A. Srivastava, B. K. H. Yen, L. Qin, H. Ahmad, G. A. Kwong, C. C. Liu, J. Gould, L. Hood and J. R. Heath, Nat. Biotechnol., 2008, 26, 1373–1378.
13 S. C. C. Shih, R. Fobel, P. Kumar and A. R. Wheeler, Lab Chip, 2011, 11, 535–540.
14 J. Gong and C. J. Kim, Lab Chip, 2008, 8, 898–906.
15 M. Abdelgawad and A. R. Wheeler, Adv. Mater., 2009, 21, 920–925. 16 A. R. Wheeler, Science, 2008, 322, 539–540.
17 S. Y. Teh, R. Lin, L. H. Hung and A. P. Lee, Lab Chip, 2008, 8, 198–220.
18 P. Tabeling, Lab Chip, 2009, 9, 2428–2436.
19 M. J. Jebrail and A. R. Wheeler, Anal. Chem., 2009, 81, 330–335. 20 N. A. Mousa, M. J. Jebrail, H. Yang, M. Abdelgawad, P. Metalnikov,
J. Chen, A. R. Wheeler and R. F. Casper, Sci. Transl. Med., 2009, 1, 1ra2.
21 M. J. Jebrail, H. Yang, J. M. Mudrik, N. M. Lafreniere, C. McRoberts, O. Y. Al-Dirbashi, L. Fisher, P. Chakraborty and A. R. Wheeler, Lab Chip, 2011, 11, 3218–3224.
22 L. K. Fiddes, V. N. Luk, S. H. Au, A. H. C. Ng, V. M. Luk, E. Kumacheva and A. R. Wheeler, Biomicrofluidics, 2012, 6, 014112. 23 L. Malic, D. Brassard, T. Veres and M. Tabrizian, Lab Chip, 2010, 10, 418–431.
24 M. G. Pollack, R. B. Fair and A. D. Shenderov, Appl. Phys. Lett., 2000, 77, 1725–1726.
25 J. Lee, H. Moon, J. Fowler, T. Schoellhammer and C. J. Kim, Sens. Actuators, A, 2002, 95, 259–268.
26 L. Mitchell, Digital chip analyzes blood from tiny drop from Futurity August, 2011,http://www.futurity.org/top-stories/digital-chip-analyzesblood-from-tiny-drop/(accessed 27 February 2012).
27 M. Abdelgawad, S. L. S. Freire, H. Yang and A. R. Wheeler, Lab Chip, 2008, 8, 672–677.
28 D. Chatterjee, B. Hetayothin, A. R. Wheeler, D. J. King and R. L. Garrell, Lab Chip, 2006, 6, 199–206.
29 T. B. Jones, Langmuir, 2002, 18, 4437–4443.
30 K. H. Kang, Langmuir, 2002, 18, 10318–10322.
31 E. Baird, P. Young and K. Mohseni, Microfluid. Nanofluid., 2007, 3, 635–644.
32 D. Chatterjee, H. Shepherd and R. L. Garrell, Lab Chip, 2009, 9, 1219–1229.
33 D. J. Griffiths, Introduction to Electrodynamics, 3 edn, Prentice-Hall, New Jersey, 1999.
34 M. Abdelgawad, P. Park and A. R. Wheeler, J. Appl. Phys., 2009, 105, 094506–094512.
35 S. K. Cho, H. J. Moon and C. J. Kim, J. Microelectromech. Syst., 2003, 12, 70–80.
36 C. G. Cooney, C. Y. Chen, M. R. Emerling, A. Nadim and J. D. Sterling, Microfluid. Nanofluid., 2006, 2, 435–446.
37 I. Barbulovic-Nad, S. H. Au and A. R. Wheeler, Lab Chip, 2010, 10, 1536–1542.
38 V. Srinivasan, V. K. Pamula and R. B. Fair, Lab Chip, 2004, 4, 310–315.
39 H. Moon, A. R. Wheeler, R. L. Garrell, J. A. Loo and C. J. Kim, Lab Chip, 2006, 6, 1213–1219.
40 S. K. Fan, H. Yang and W. Hsu, Lab Chip, 2011, 11, 343–347. 41 M. Abdelgawad, M. W. L. Watson and A. R. Wheeler, Lab Chip, 2009, 9, 1046–1051.
42 M. W. L. Watson, M. J. Jebrail and A. R. Wheeler, Anal. Chem., 2010, 82, 6680–6686.
43 M. J. Jebrail and A. R. Wheeler, Curr. Opin. Chem. Biol., 2010, 14, 574–581.
44 H. Kim, M. S. Bartsch, R. F. Renzi, J. He, J. L. Van de Vreugde,
M. R. Claudnic and K. D. Patel, J. Lab. Autom., 2011, 16, 405–414. 45 S. C. C. Shih, H. Yang, M. J. Jebrail, R. Fobel, N. McIntosh, O. Y. Al-Dirbashi, P. Chakraborty and A. R. Wheeler, Anal. Chem., 2012, 84, 3731–3738.

46 J. Gorbatsova, M. Jaanus and M. Kaljurand, Anal. Chem., 2009, 81, 8590–8595.
47 N. Thaitrong, H. Kim, R. F. Renzi, M. S. Bartsch, R. J. Meagher and K. D. Patel, 2012Submitted.
48 C. A. Baker and M. G. Roper, Anal. Chem., 2012, 84, 2955, DOI: 10.1021/ac300100b.
49 J. R. Millman, K. H. Bhatt, B. G. Prevo and O. D. Velev, Nat. Mater., 2004, 4, 98–102.
50 P. Dubois, G. Marchand, Y. Fouillet, J. Berthier, T. Douki, F. Hassine,
S. Gmouh and M. Vaultier, Anal. Chem., 2006, 78, 4909–4917.
51 M. J. Jebrail, A. H. C. Ng, V. Rai, R. Hili, A. K. Yudin and A. R. Wheeler, Angew. Chem., Int. Ed., 2010, 49, 8625–8629.
52 P. Y. Keng, S. Chen, H. Ding, S. Sadeghi, G. J. Shah, A. Dooraghi,
M. E. Phelps, N. Satyamurthy, A. F. Chatziioannou, C. J. Kim and
R. M. Van Dam, Proc. Natl. Acad. Sci. U. S. A., 2011, 109, 690–695. 53 D. Witters, N. Vergauwe, R. Ameloot, S. Vermeir, D. De Vos, R. Puers, B. Sels and J. Lammertyn, Adv. Mater., 2012, 24, 1316–1320. 54 J. Y. Wang, G. D. Sui, V. P. Mocharla, R. J. Lin, M. E. Phelps,
H. C. Kolb and H. R. Tseng, Angew. Chem., Int. Ed., 2006, 45, 5276–5281.
55 Y. Kikutani, T. Horiuchi, K. Uchiyama, H. Hisamoto, M. Tokeshi and T. Kitamori, Lab Chip, 2002, 2, 188–192.
56 E. R. Murphy, J. R. Martinelli, N. Zaborenko, S. L. Buchwald and
K. F. Jensen, Angew. Chem., Int. Ed., 2007, 46, 1734–1737.
57 M. Baumann, I. R. Baxendale, S. V. Ley, N. Nikbin, C. D. Smith and J. P. Tierney, Org. Biomol. Chem., 2008, 6, 1577–1586.
58 V. Srinivasan, V. K. Pamula and R. B. Fair, Anal. Chim. Acta, 2004, 507, 145–150.
59 V. N. Luk, G. C. H. Mo and A. R. Wheeler, Langmuir, 2008, 24, 6382–6389.
60 S. H. Au, P. Kumar and A. R. Wheeler, Langmuir, 2011, 27, 8586–8594.
61 G. Perry, V. Thomy, M. R. Das, Y. Coffinier and R. Boukherroub, Lab Chip, 2012, 12, 1601.
62 H. Yang, V. N. Luk, M. Abeigawad, I. Barbulovic-Nad and A. R. Wheeer, Anal. Chem., 2009, 81, 1061–1067.
63 D. Jary, A. Chollat-Namy, Y. Fouillet, J. Boutet, C. Chabrol, G. Castellan, D. Gasparutto and C. Peponnet, Proceedings of 2006 NSTI Nanotechnology Conference and Trade Show, 2006, 2554–557. 64 Y. J. Liu, D. J. Yao, H. C. Lin, W. Y. Chang and H. Y. Chang,
J. Micromech. Microeng., 2008, 18, 045017.
65 L. Malic, T. Veres and M. Tabrizian, Biosens. Bioelectron., 2009, 24, 2218–2224.
66 L. Malic, T. Veres and M. Tabrizian, Biosens. Bioelectron., 2011, 26, 2053–2059.
67 Y. H. Chang, G. B. Lee, F. C. Huang, Y. Y. Chen and J. L. Lin, Biomed. Microdevices, 2006, 8, 215–225.
68 R. Sista, Z. S. Hua, P. Thwar, A. Sudarsan, V. Srinivasan, A. Eckhardt, M. Pollack and V. Pamula, Lab Chip, 2008, 8, 2091–2104. 69 Z. Hua, J. L. Rouse, A. E. Eckhardt, V. Srinivasan, V. K. Pamula,
W. A. Schell, J. L. Benton, T. G. Mitchell and M. G. Pollack, Anal. Chem., 2010, 82, 2310–2316.
70 D. J. Boles, J. L. Benton, G. J. Siew, M. H. Levy, P. K. Thwar,
M. A. Sandahl, J. L. Rouse, L. C. Perkins, A. P. Sudarsan, R. Jalili,
V. K. Pamula, V. Srinivasan, R. B. Fair, P. B. Griffin, A. E. Eckhardt and M. G. Pollack, Anal. Chem., 2011, 83, 8439–8447. 71 T. Taniguchi, T. Torii and T. Higuchi, Lab Chip, 2002, 2, 19–23. 72 K. P. Nichols and J. G. E. Gardeniers, Anal. Chem., 2007, 79, 8699–8704. 73 E. M. Miller and A. R. Wheeler, Anal. Chem., 2008, 80, 1614–1619. 74 A. R. Wheeler, H. Moon, C. J. Kim, J. A. Loo and R. L. Garrell, Anal. Chem., 2004, 76, 4833–4838.
75 A. R. Wheeler, H. Moon, C. A. Bird, R. R. O. Loo, C. J. Kim, J. A. Loo and R. L. Garrell, Anal. Chem., 2005, 77, 534–540.
76 V. N. Luk and A. R. Wheeler, Anal. Chem., 2009, 81, 4524–4530. 77 D. Chatterjee, A. J. Ytterberg, S. U. Son, J. A. Loo and R. L. Garrell, Anal. Chem., 2010, 82, 2095–2101.
78 W. C. Nelson, I. Peng, G. A. Lee, J. A. Loo, R. L. Garrell and C. J. Kim, Anal. Chem., 2010, 82, 9932–9937.
79 M. J. Jebrail, V. N. Luk, S. C. C. Shih, R. Fobel, A. H. C. Ng, H. Yang, S. L. S. Freire and A. R. Wheeler, J. Vis. Exp., 2009, e1603, DOI: 1610.3791/1603.
80 V. N. Luk, L. K. Fiddes, V. M. Luk, E. Kumacheva and A. R. Wheeler, Proteomics, 2012, 12, 1310, DOI: 10.1002/pmic.201100608. 81 R. S. Sista, A. E. Eckhardt, V. Srinivasan, M. G. Pollack, S. Palanki and V. K. Pamula, Lab Chip, 2008, 8, 2188–2196.
Downloaded by North Carolina State University on 24 January 2013 Published on 10 May 2012 on http://pubs.rsc.org | doi:10.1039/C2LC40318H View Article Online

82 E. M. Miller, A. H. C. Ng, U. Uddayasankar and A. R. Wheeler, Anal. Bioanal. Chem., 2010, 399, 337–345.
83 D. Bogojevic, M. D. Chamberlain, I. Barbulovic-Nad and A. R. Wheeler, Lab Chip, 2012, 12, 627–634.
84 I. Barbulovic-Nad, H. Yang, P. S. Park and A. R. Wheeler, Lab Chip, 2008, 8, 519–526.
85 J. Zhou, L. Lu, K. Byrapogu, D. Wootton, P. Lelkes and R. Fair, Virtual Phys. Prototyping, 2007, 2, 217–223.
86 S. K. Fan, P. W. Huang, T. T. Wang and Y. H. Peng, Lab Chip, 2008, 8, 1325–1331.
87 G. J. Shah, A. T. Ohta, E. P. Y. Chiou, M. C. Wu and C. J. Kim, Lab Chip, 2009, 9, 1732–1739.
88 S. Srigunapalan, I. A. Eydelnant, C. A. Simmons and A. R. Wheeler, Lab Chip, 2012, 12, 369–375.
89 I. A. Eydelnant, U. Uddayasankar, B. Li, M. W. Liaoab and A. R. Wheeler, Lab Chip, 2012, 12, 750–757.
90 H. Yang, J. M. Mudrik, M. J. Jebrail and A. R. Wheeler, Anal. Chem., 2011, 83, 3824–3830.
91 P. A. L. Wijethunga, Y. S. Nanayakkara, P. Kunchala, D. W. Armstrong and H. Moon, Anal. Chem., 2011, 83, 1658–1664.

92 R. S. Sista, A. E. Eckhardt, T. Wang, C. Graham, J. L. Rouse, S. M. Norton, V. Srinivasan, M. G. Pollack, A. A. Tolun, D. Bali, D. S. Millington and V. K. Pamula, Clin. Chem., 2011, 57, 1444–1451. 93 C. Arnaud, Chem. Eng. News, 2011, 89, 13–17.
94 Y. Zhao and S. K. Cho, Lab Chip, 2007, 7, 273–280.
95 Y. Zhao, S. K. Chung, U. C. Yi and S. K. Cho, J. Micromech. Microeng., 2008, 18.
96 A. Gao, X. Liu, T. Li, P. Zhou, Y. Wang, Q. Yang, L. Wang and C. Fan, IEEE Sens. J., 2011, 11, 2820–2824.
97 A. J. C. Kuehne, M. C. Gather, I. A. Eydelnant, S. H. Yun, D. A. Weitz and A. R. Wheeler, Lab Chip, 2011, 11, 3716–3719.
98 J. L. Poulos, W. C. Nelson, T. J. Jeon, C. J. Kim and J. J. Schmidt, Appl. Phys. Lett., 2009, 95.
99 S. U. Son and R. L. Garrell, Lab Chip, 2009, 9, 2398–2401.
100 S. H. Au, S. C. C. Shih and A. R. Wheeler, Biomed. Microdevices, 2010, 13, 41–50.
101 F. Lapierre, G. Piret, H. Drobecq, O. Melnyk, Y. Coffinier, V. Thomy and R. Boukherroub, Lab Chip, 2011, 11, 1620–1628. 102 K. Choi, J.-Y Kim, J.-H. Ahn, J.-M. Choi, M. a. Imb and Y.-K. Choi, Lab Chip, 2012, 12, 1533–1536.
The Royal Society of Chemistry 2012 | Lab Chip, 2012, 12, 2452–2463 | 2463
Downloaded by North Carolina State University on 24 January 2013 Published on 10 May 2012 on http://pubs.rsc.org | doi:10.1039/C2LC40318H View Article Online
