vtmkhoi/DigitalMicroFluidics/hardware/DMF_ver02_FET/DMF_ver02_FET.kicad_pcb

## KiCad design hardware/DMF_ver02_FET/DMF_ver02_FET.kicad_pcb (2022-10-18)

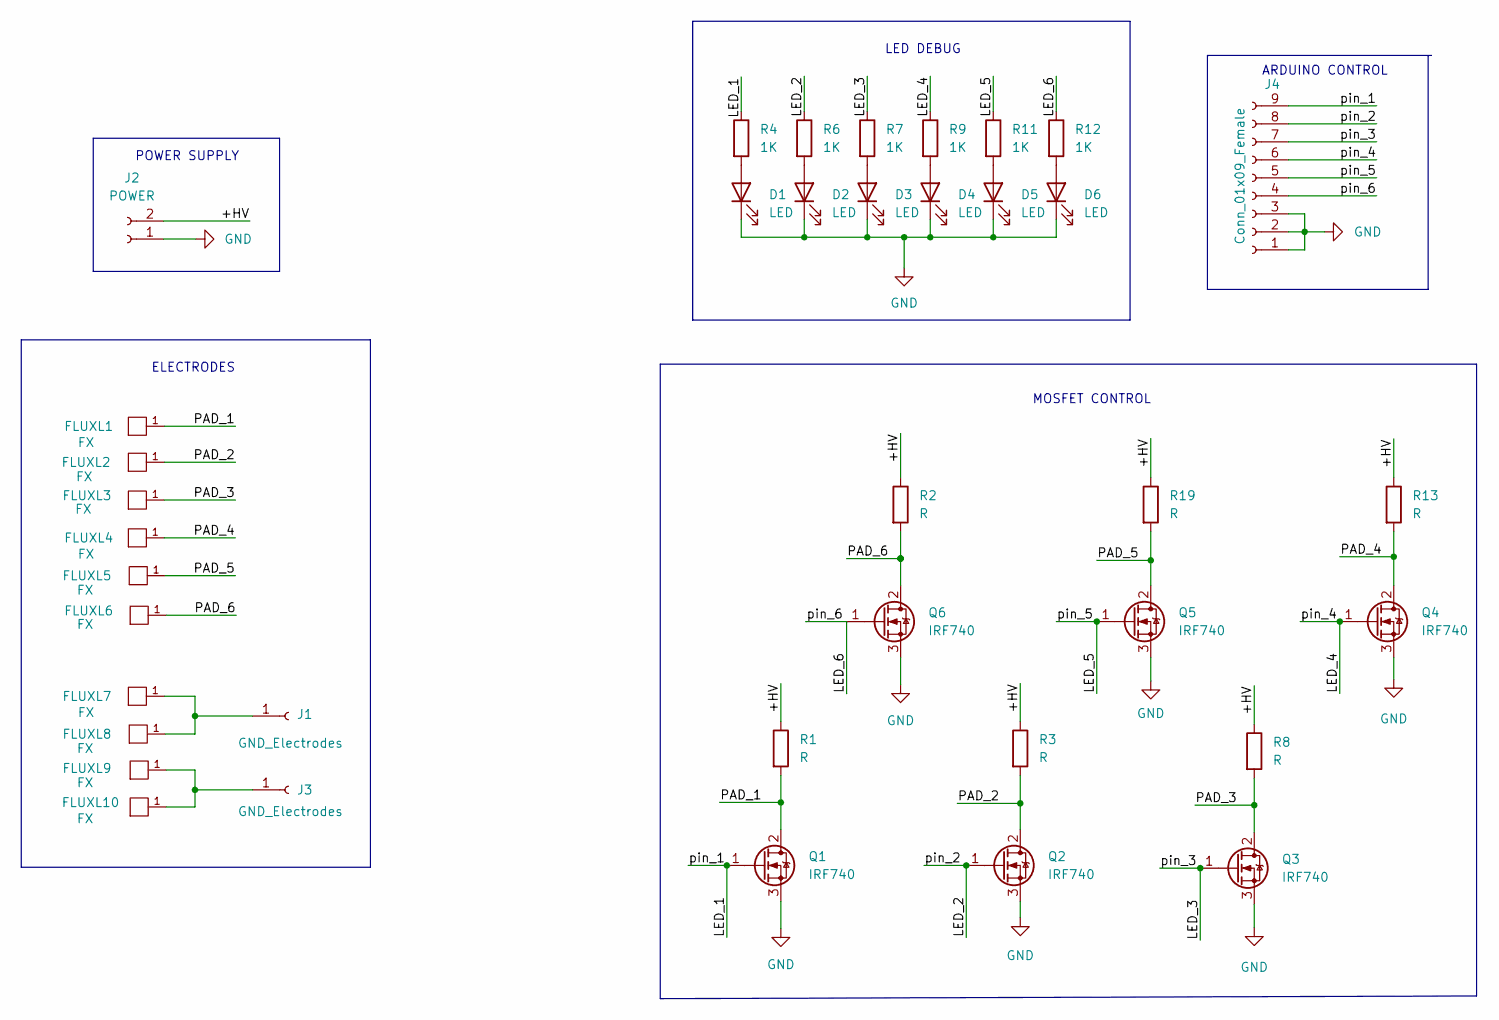
[picture p83: schematic DMF_ver02_FET.kicad_sch, DigitalMicroFluicis]

Parts:
D1, D2, D3, D4, D5, D6: LED; LED_0603_1608Metric_Pad1.05x0.95mm_HandSolder
FLUXL1, FLUXL2, FLUXL3, FLUXL4, FLUXL5, FLUXL6, FLUXL7, FLUXL8, FLUXL9, FLUXL10: FX; FLUXPAD_2_75_4MIL_FINAL
J1, J3: GND_Electrodes; PinSocket_1x01_P2.54mm_Vertical
J2: POWER; TerminalBlock_bornier-2_P5.08mm
J4: Conn_01x09_Female; PinHeader_1x09_P2.54mm_Vertical
Q1, Q2, Q3, Q4, Q5, Q6: IRF740; TO-263-3_TabPin2
R1, R2, R3, R8, R13, R19: R; R_1206_3216Metric_Pad1.30x1.75mm_HandSolder
R4, R6, R7, R9, R11, R12: 1K; R_1206_3216Metric_Pad1.30x1.75mm_HandSolder

Connections:
/+HV: J2.2, R1.1, R2.1, R3.1, R8.1, R13.1, R19.1
/LED_1: J4.9, Q1.1 (G), R4.1
/LED_2: J4.8, Q2.1 (G), R6.1
/LED_3: J4.7, Q3.1 (G), R7.1
/LED_4: J4.6, Q4.1 (G), R9.1
/LED_5: J4.5, Q5.1 (G), R11.1
/LED_6: J4.4, Q6.1 (G), R12.1
/PAD_1: FLUXL1.1, Q1.2 (D), R1.2
/PAD_2: FLUXL2.1, Q2.2 (D), R3.2
/PAD_3: FLUXL3.1, Q3.2 (D), R8.2
/PAD_4: FLUXL4.1, Q4.2 (D), R13.2
/PAD_5: FLUXL5.1, Q5.2 (D), R19.2
/PAD_6: FLUXL6.1, Q6.2 (D), R2.2
GND: D1.1 (K), D2.1 (K), D3.1 (K), D4.1 (K), D5.1 (K), D6.1 (K), J2.1, J4.1, J4.2, J4.3, Q1.3 (S), Q2.3 (S), Q3.3 (S), Q4.3 (S), Q5.3 (S), Q6.3 (S)
unnamed: D1.2 (A), R4.2
unnamed: D2.2 (A), R6.2
unnamed: D3.2 (A), R7.2
unnamed: D4.2 (A), R9.2
unnamed: D5.2 (A), R11.2
unnamed: D6.2 (A), R12.2
unnamed: FLUXL7.1, FLUXL8.1, J1.1
unnamed: FLUXL9.1, FLUXL10.1, J3.1

Notes on the sheet:
POWER SUPPLY
ARDUINO CONTROL
LED DEBUG
ELECTRODES
MOSFET CONTROL

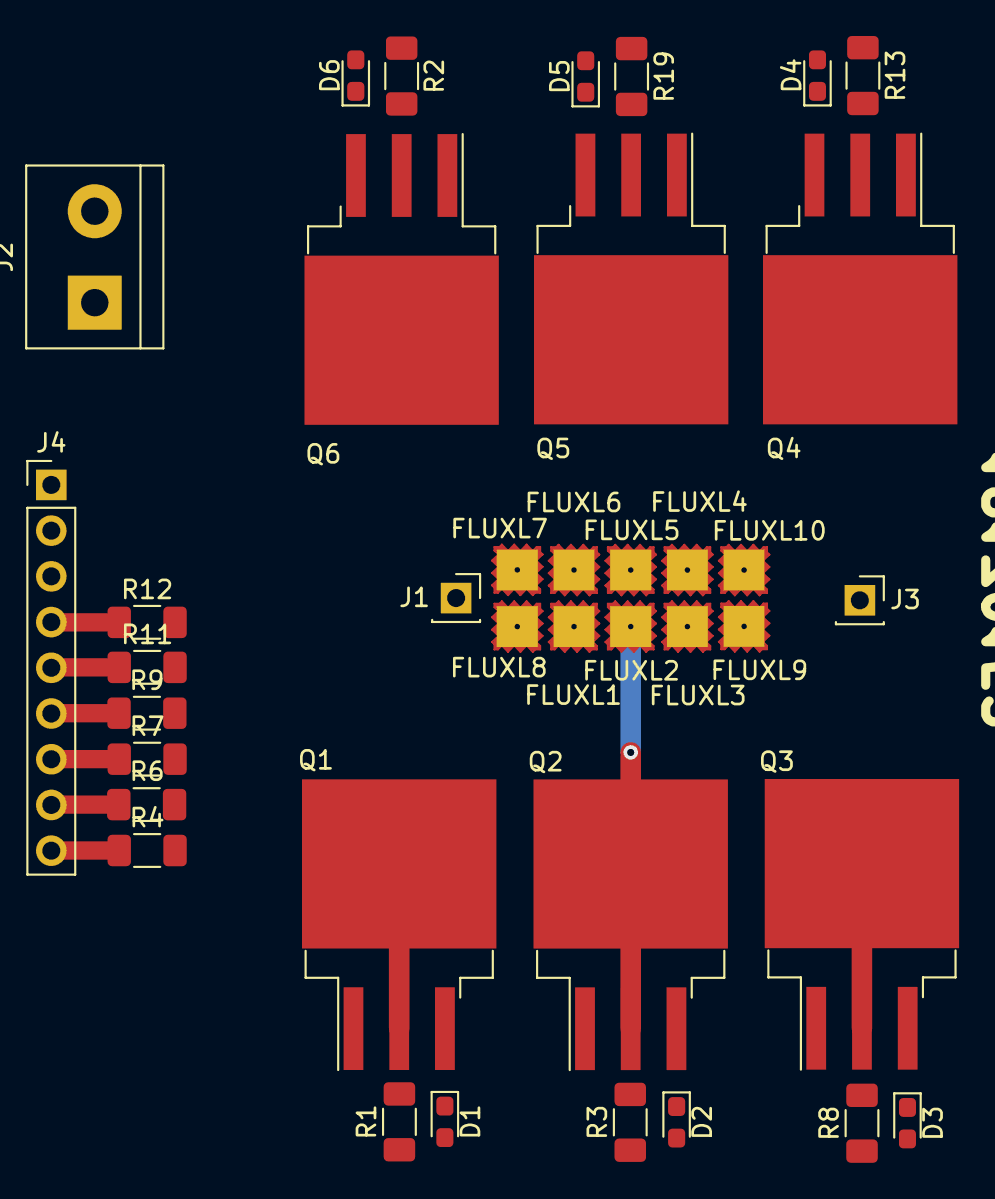
[picture p84: board DMF_ver02_FET.kicad_pcb from above]

Board: 2 copper layers, 38 parts (0 on the bottom side), 22 nets.
