vtmkhoi/DigitalMicroFluidics/(commit log)

2022-09-27 Update Schematic of DMF Project
    [MFD_demo.kicad_pcb, MFD_demo.kicad_sch]
2022-09-27 Update documents
    [MFD_demo.kicad_pcb]
2022-09-27 Modify folder structure
    [MFD_demo.kicad_pcb]
2022-09-30 Update schem + layout PCB: Changes from 10 electrodes -> 6 electrodes
    [MFD_demo.kicad_pcb, MFD_demo.kicad_sch]
2022-10-01 Update PCB layout version 01
    [MFD_demo.kicad_pcb, MFD_demo.kicad_sch]
2022-10-01 Update PCB layout
    [MFD_demo.kicad_pcb, MFD_demo.kicad_sch]
2022-10-04 Update PCB layout: electrodes distances: 0.5mm
    [MFD_demo.kicad_pcb]
2022-10-17 Create DMF board version SMD
    [DMF_ver02_FET.kicad_pcb, DMF_ver02_FET.kicad_sch]
2022-10-17 Update folder structure. Create Version SMD
    [DMF_ver01_FET.kicad_pcb, DMF_ver01_FET.kicad_sch]
2022-10-18 Update PCB layout: Placed components.
    [DMF_ver02_FET.kicad_pcb, DMF_ver02_FET.kicad_sch]
